philippedc/Arduino-Uno-Power-Router-for-Load-Shedding-home-made-electricity-power-in-exceed/power-router_pcb.JPG

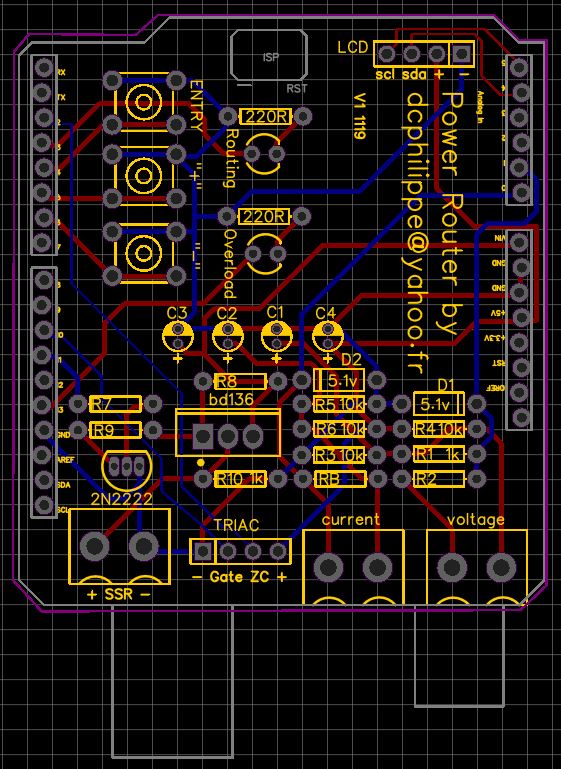
power-router_pcb.JPG
