philippedc/Arduino-Uno-Power-Router-for-Load-Shedding-home-made-electricity-power-in-exceed/presentation picture.png

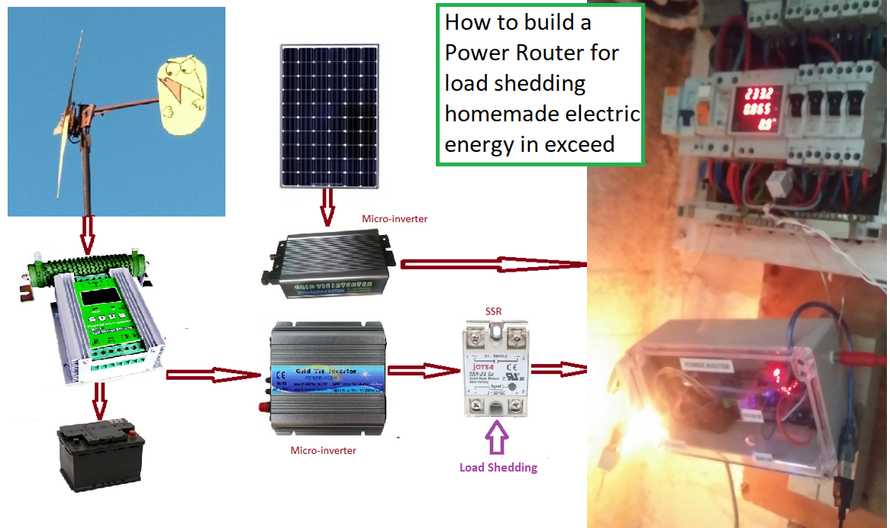
presentation picture.png
